siqiyan/BananaKit2/doc/hardware_list.md

# Hardware List

| Component Name | Qty | Note |
|---|---|---|
| Arduino Nano | 1 | |
| 2004A LCD | 1 | |
| PCF8574T I2C Adapter | 1 | |
| 12400 battery | 2 | |
| AA battery case x2 | 1 | |
| Battery Charger | 1 | Optional |
| LM2569 Voltage Regulator | 1 | |
| Prototyping PCB 7x9cm | 1 | |
| Prototyping PCB 3x7cm | - | Varies |
| Prototyping PCB 4x6cm | - | Varies |
| Potentiometer B10K | 1 | |
| M to F 8-Pin Connector | 4 | |
| M to F 15-Pin Connector | 2 | |
| M to F 4-Pin Connector | 1 | |
| M to M 8-pin Connector | - | Varies, each module requires 2 |
| VS1838B IR Receiver | 1 | |
| IR Remote Controller | 1 | |
| Power Switch | 1 | |
| Hookup Wires | - | Sufficient amount |
