siqiyan/BananaKit2/doc/mainboard_specs.md

# Mainboard Specs

Here is the BananaKit2 Mainboard blueprint:

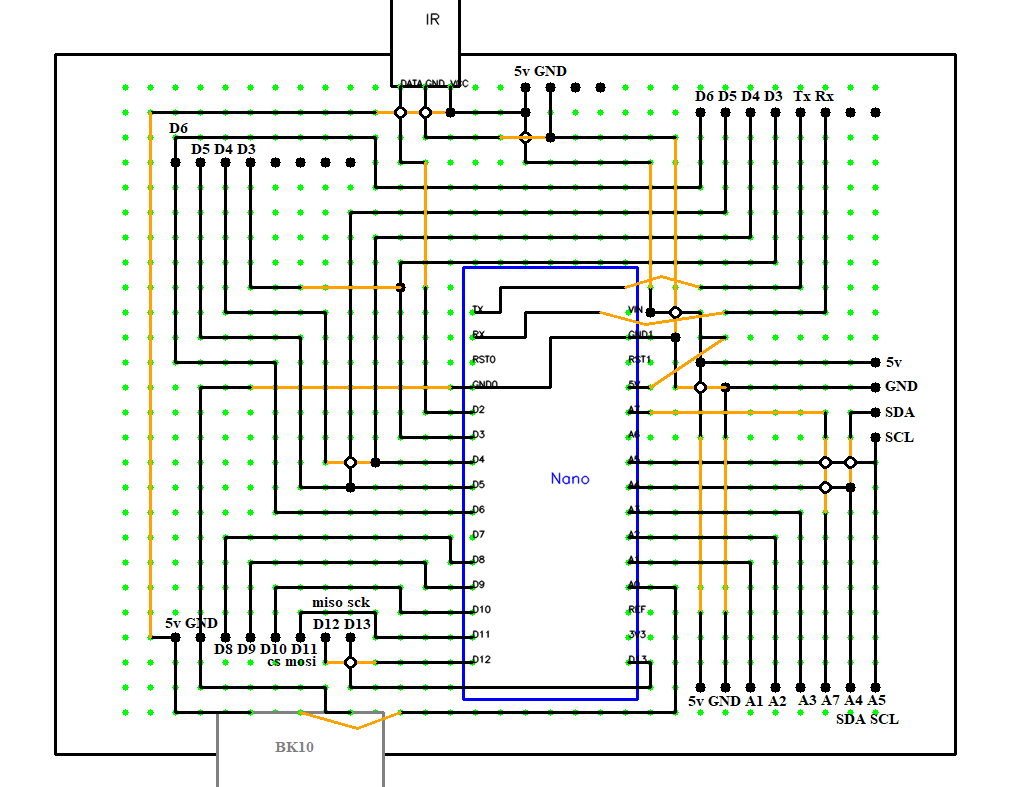
[picture p7: doc/mainboard_blueprint.png]
Mainboard Blueprint


Building this PCB requires lot of soldering work, but when its done the mainboard will looks like this:

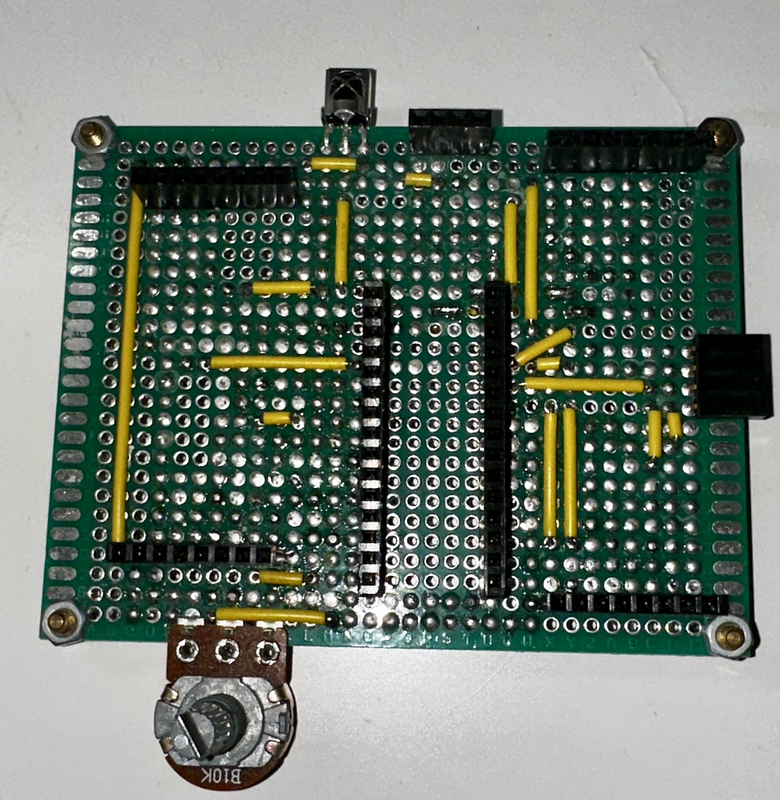
[picture p8: doc/mainboard_front.jpg]
Mainboard Front


And the back will looks like:

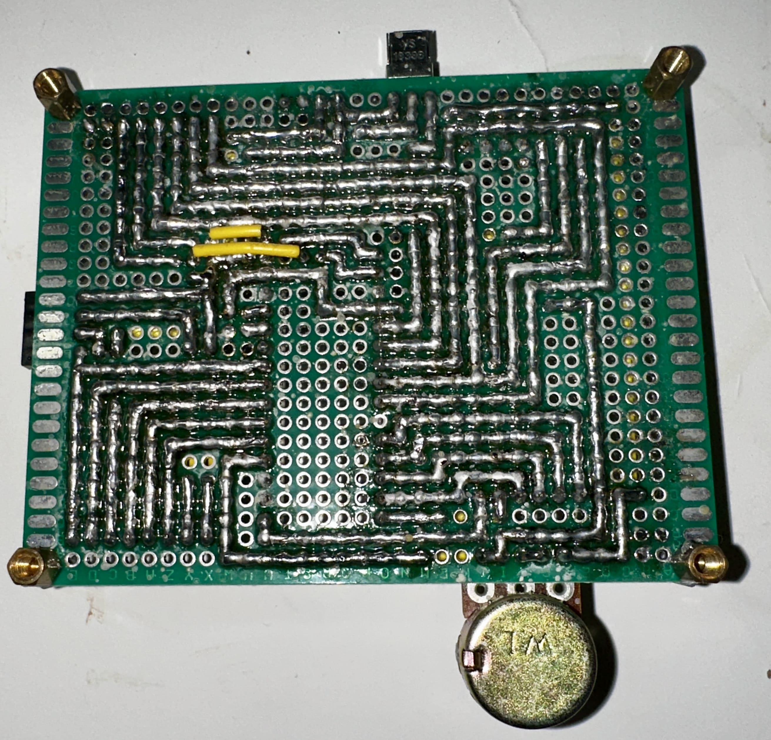
[picture p9: doc/mainboard_back.jpg]
Mainboard Back
