siqiyan/BananaKit2/doc/gps_imu_blueprint.png

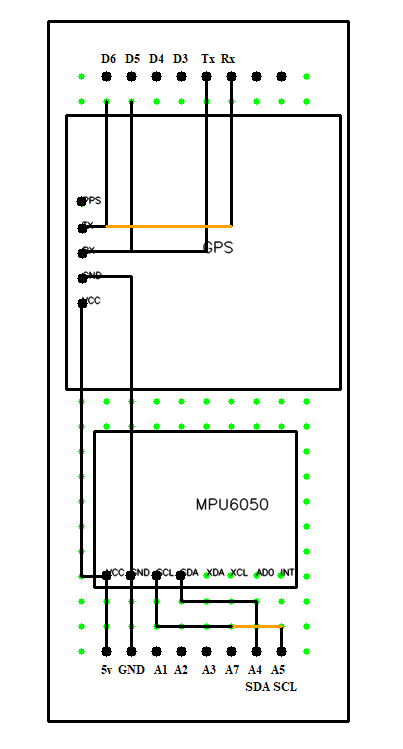
doc/gps_imu_blueprint.png
