siqiyan/BananaKit2/doc/nrf24_module_blueprint.png

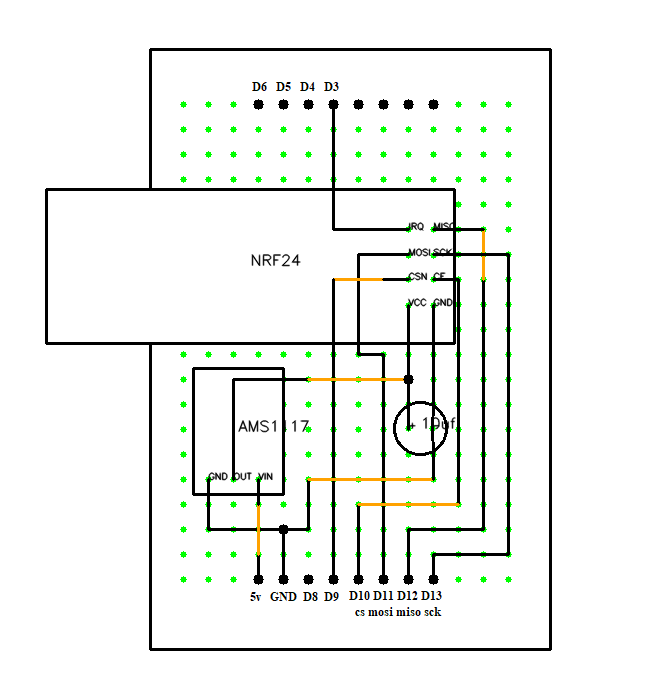
doc/nrf24_module_blueprint.png
