siqiyan/BananaKit2/doc/custom_module_guide.md

# Custom Module Prototyping Guide

Each module requires two 8Pin male connectors.

The 3x7cm module has I2C, UART, D3-D6, A1-A5 and A7 pin access to the Arduino
Nano, suitable for analog sensors. The 4x6cm module has SPI, D3-D6, D8 and D9
pin access mainly for digital and SPI components.

Both types of modules are power supplied at 5V and can be connected
simultaneously to BananaKit2.

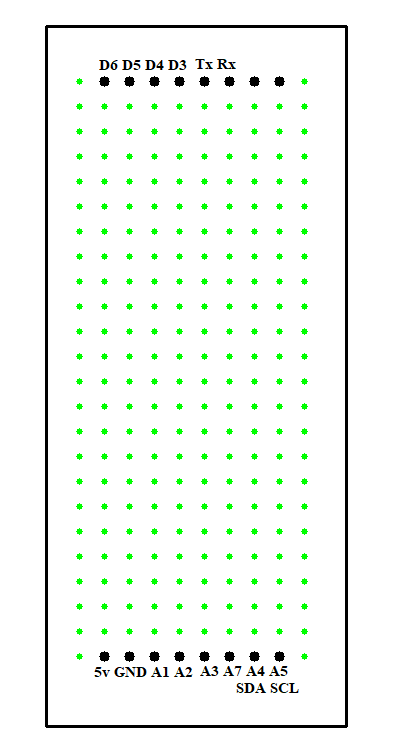
[picture p14: doc/empty_module_3x7.png]
Module Pinout 3x7CM


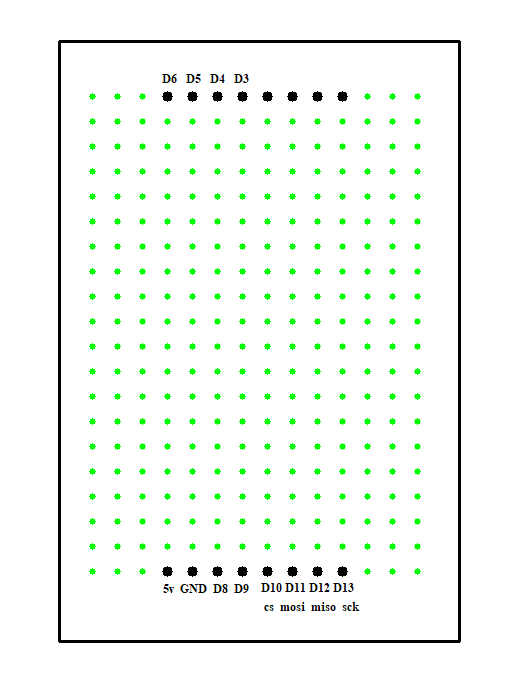
[picture p15: doc/empty_module_4x6.png]
Module Pinout 4x6CM
