siqiyan/BananaKit2/src/module/gps_module/gps_module.h

#ifndef __GPS_MODULE__
#define __GPS_MODULE__

#include "lib/bananakit/callstack.h"

void gps_module_init(void);
node_status_t gps_module_update(void);
void gps_module_resume(void);
void gps_module_exit(void);

#endif
