siqiyan/BananaKit2/src/module/joystick_module/joystick_module.h

#ifndef __JOYSTICK__
#define __JOYSTICK__

#include "lib/bananakit/callstack.h"

void joystick_init(void);
node_status_t joystick_update(void);
void joystick_resume(void);
void joystick_exit(void);

#endif
