siqiyan/BananaKit2/(commit log)

2025-10-07 migration; finished basic framework (io, callstack, menu); migrate radio module(not work yet)
    [BananaKitV2.ino, bananakit.h, radio.cpp, radio.h, radio_module.cpp, radio_module.h, radio_references.h, signal_process.cpp]
2025-10-07 new interrupt mechanism; update radio api
2025-10-13 added new rc station code (not work yet)
    [rc_station.cpp, rc_station.h]
2025-10-13 added volt0 reading
2025-10-13 updated new rc_station code (still not work yet)
    [rc_station.cpp, rc_station.h]
2025-10-18 added gnss_reader, show lat/lon on lcd (not work, segment fault)
    [BananaKit2.ino, bananakit.h, gps_imu_module.cpp]
2025-10-29 fix bug from previous commit
    [gps_imu_module.cpp]
2025-10-30 optimized gnss buf proc&data update; fixed small disp issue
    [gps_imu_module.cpp]
2025-11-01 added imu_reader for detailed data reading
2025-11-30 seperated gps from imu module; added gps origin and gps2localxy;
2025-12-02 added microsd module; fixed main menu disp issue
    [BananaKit2.ino, bananakit.h, microsd_module.cpp, microsd_module.h]
2025-12-03 major update
    optimized gnss_reader error codes and return types; bug fix
    optimized gps_module display;
    use macros to force linker garbage removal in every modules, reduces compiled binary space
    [bananakit.h, gps_module.cpp, imu_module.cpp, joystick_module.cpp, microsd_module.cpp, radio_module.cpp, rc_station.cpp]
2025-12-18 fixed steer throttle disp issue
    [bananakit.h, rc_station.cpp, rc_station.h, rc_vehicle_common.h]
2025-12-18 fix rc_station disp issue
    [bananakit.h, rc_station.cpp, rc_station.h]
2026-01-07 added gps, ekf, navi frames
2026-01-12 cmd vel to int8_t; continus gear; abandom ekf
2026-01-13 fix rotation direction (use righthand coord)
    [rc_station.cpp]
2026-01-13 add gps ori bit in gps frame
2026-01-13 fixed auto/manu navi mode swtich
    [rc_station.cpp, rc_station.h, rc_vehicle_common.h]
2026-01-15 fixed cmd_yaw dir&scaling issue
    [rc_station.cpp, rc_station.h, rc_vehicle_common.h]
2026-01-16 add dir macro; small fix
    [rc_station.cpp, rc_vehicle_common.h]
2026-02-24 changed r1 r2 values; fixed voltage measure issue; changed joy neutral pos
    [bananakit.h, dc_motor_module.cpp, rc_station.cpp]
2026-03-06 added docs for mainboard soldering
2026-03-08 added dc motor module doc
2026-03-08 modified the dc motor module doc
